JoeyStrandnes/C-tron_SensorConverter-Cerlic/Electrical/SensorConverter/PCB_Outline.dxf

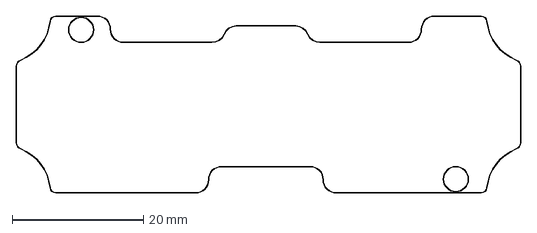
[picture p1: CAD file, 2025-03-11]
Electrical/SensorConverter/PCB_Outline.dxf
77.0 x 27.0 mm
