JoeyStrandnes/C-tron_SensorConverter-Cerlic/Electrical/SensorConverter/SensorConverter.kicad_pcb

## KiCad design Electrical/SensorConverter/SensorConverter.kicad_pcb (2025-04-03)

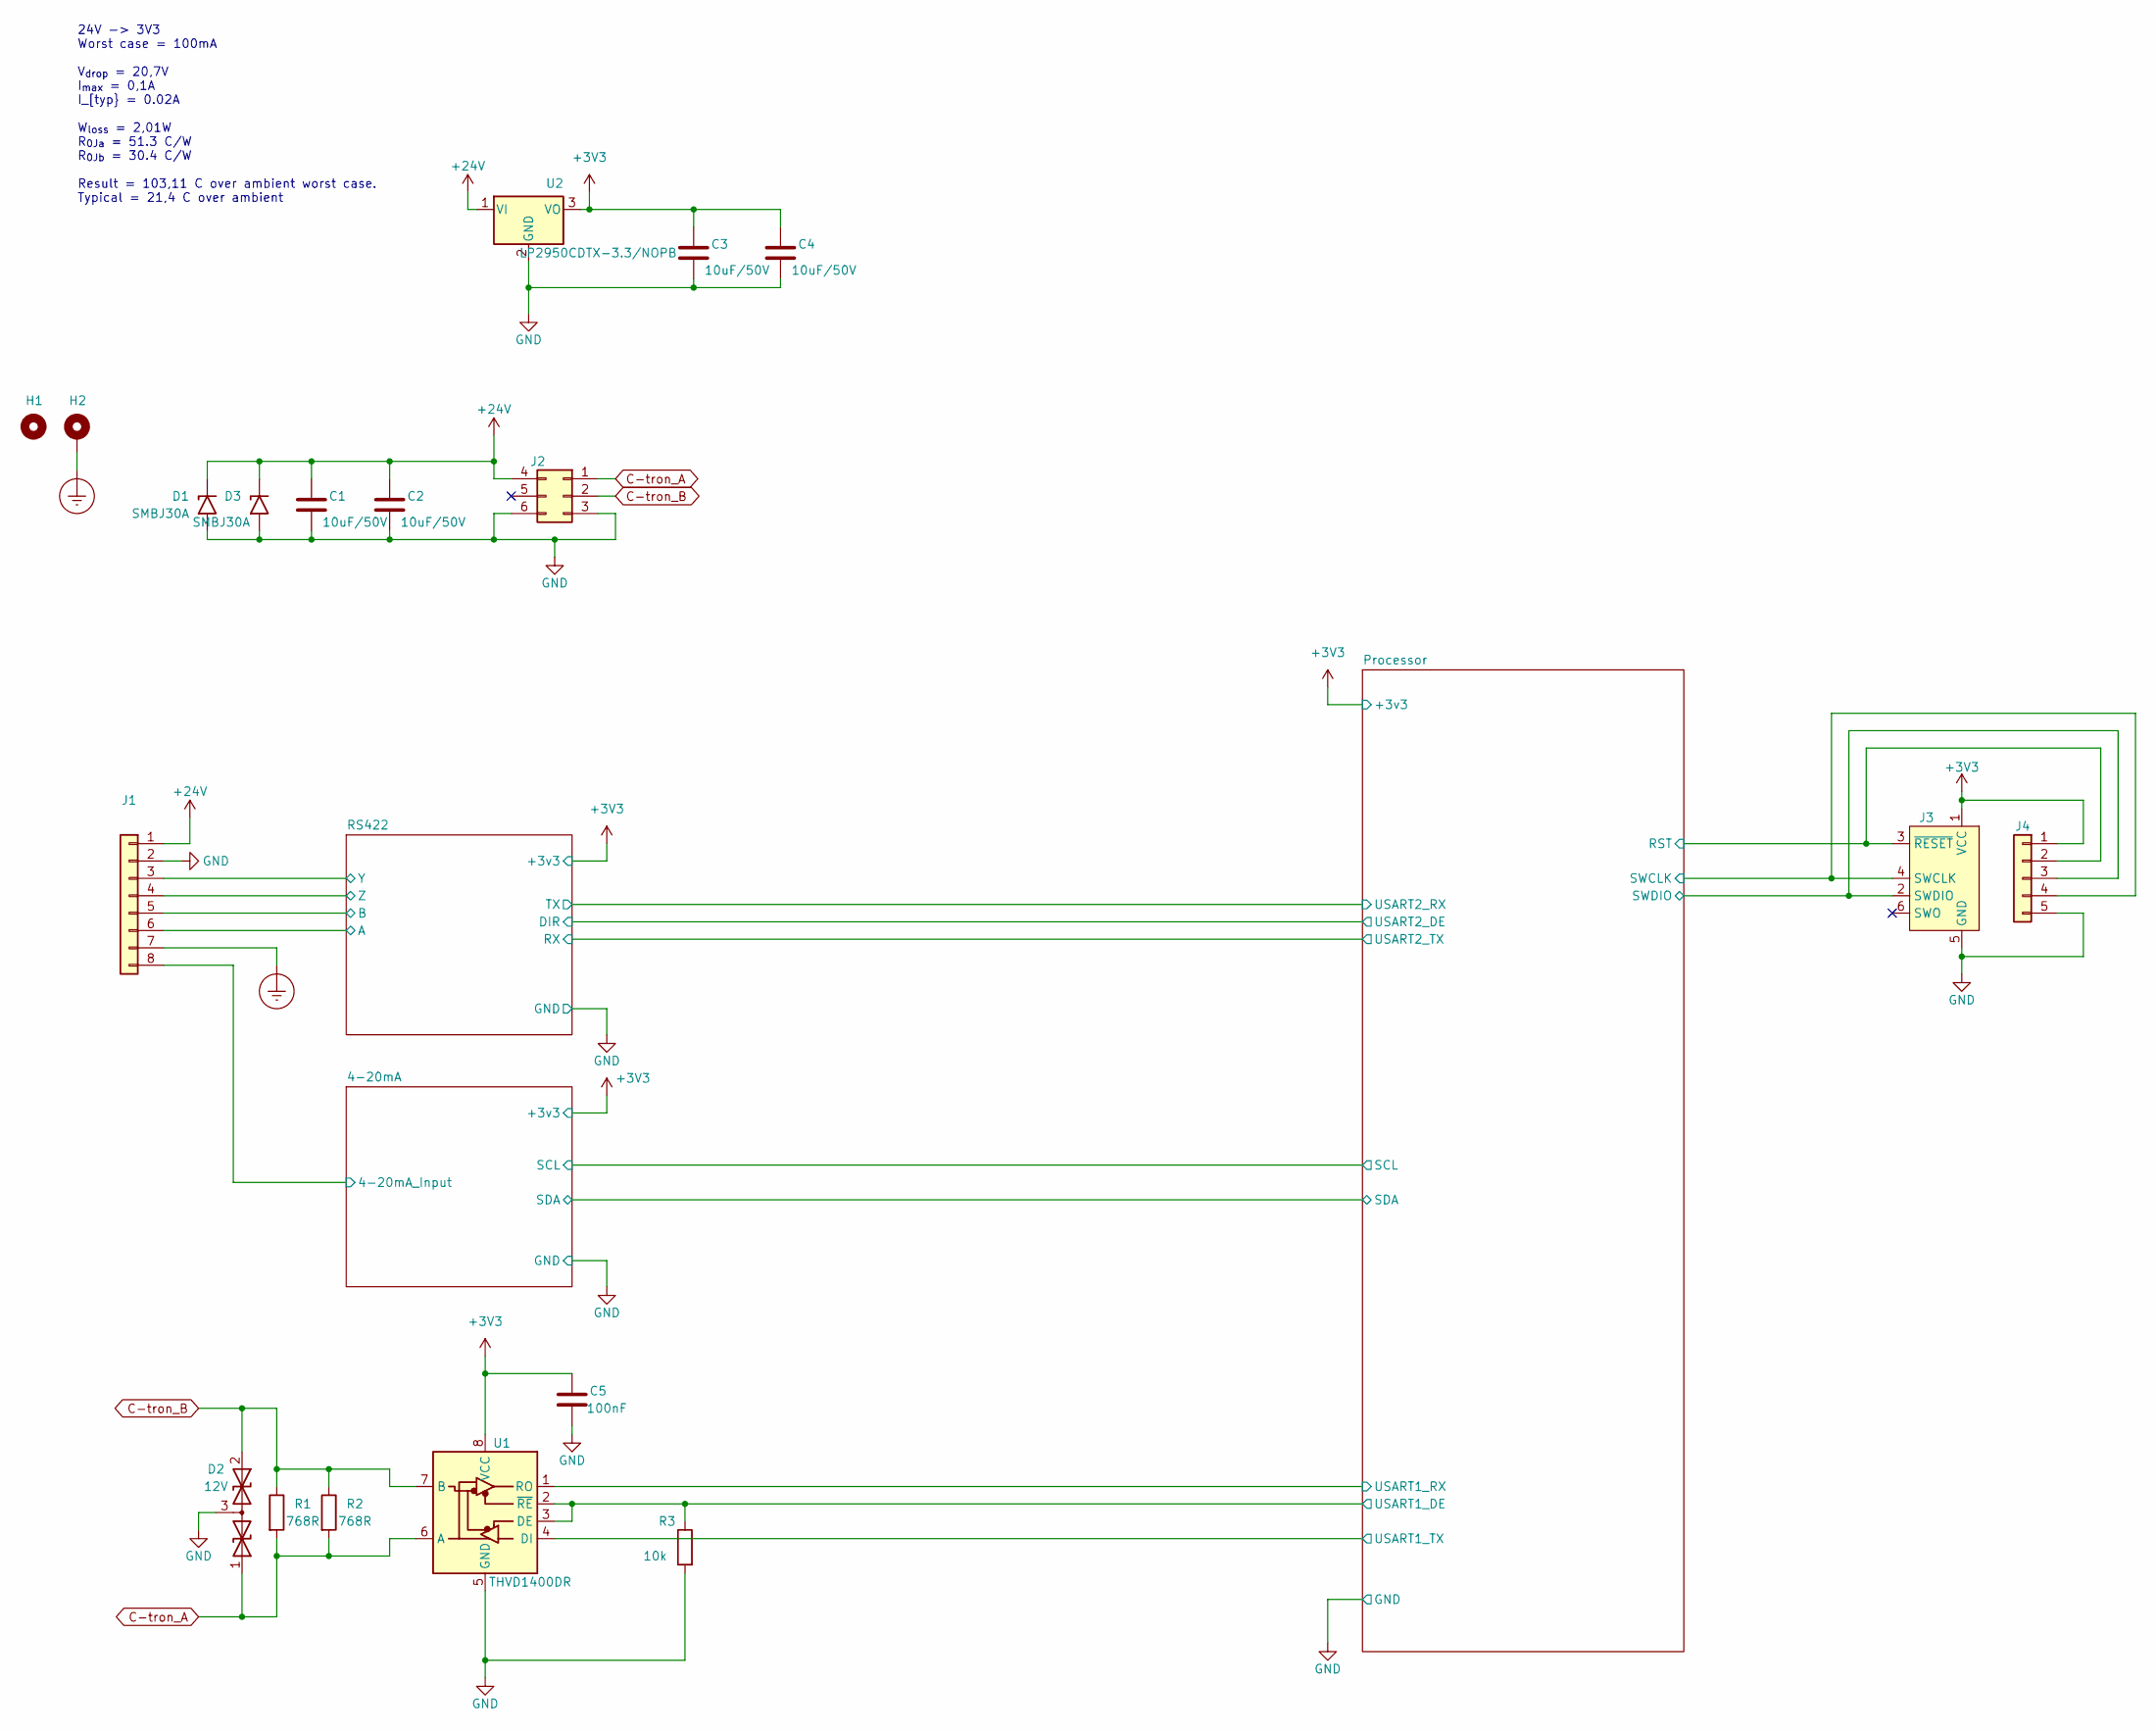
[picture p2: schematic SensorConverter.kicad_sch, Sensor Conversion board]

Parts:
C1, C2, C3, C4: 10uF/50V; C_1206_3216Metric
C5: 100nF; C_0402_1005Metric; Voltage 25V
D1, D3: SMBJ30A; D_SMB
D2: 12V; SOT-323_SC-70; MPN DF3D18FU,LF
H1: MountingHole; MountingHole_3.2mm_M3
H2: MountingHole_Pad; MountingHole_3.2mm_M3_DIN965_Pad
J1: 1990067
J2: 0430450600
J3: Conn_ARM_SWD_TagConnect_TC2030-NL; Tag-Connect_TC2030-IDC-NL_2x03_P1.27mm_Vertical
J4: Conn_01x05; PinHeader_1x05_P1.27mm_Vertical
R1, R2: 768R; R_0603_1608Metric
R3: 10k; R_0402_1005Metric
U1: THVD1400DR; SOIC-8_3.9x4.9mm_P1.27mm
U2: LP2950CDTX-3.3/NOPB; TO-252-2

Connections:
+3V3: C3.2, C4.2, C5.2, J3.1 (VCC), J4.1, U1.8 (VCC), U2.3 (VO); also elsewhere on the board
+24V: C1.2, C2.2, D1.1 (A1), D3.1 (A1), J1.1, J2.4, U2.1 (VI)
/4-20mA/4-20mA_Input: J1.8; also elsewhere on the board
/Processor/RST: J3.3 (~RESET), J4.2; also elsewhere on the board
/Processor/SWCLK: J3.4 (SWCLK), J4.4; also elsewhere on the board
/Processor/SWDIO: J3.2 (SWDIO), J4.3; also elsewhere on the board
/Processor/USART1_DE: R3.1, U1.2 (~RE), U1.3 (DE); also elsewhere on the board
/Processor/USART1_RX: U1.1 (RO); also elsewhere on the board
/Processor/USART1_TX: U1.4 (DI); also elsewhere on the board
/RS422/A: J1.6; also elsewhere on the board
/RS422/B: J1.5; also elsewhere on the board
/RS422/Y: J1.3; also elsewhere on the board
/RS422/Z: J1.4; also elsewhere on the board
C-tron_A: D2.1 (A1), J2.1, R1.2, R2.2, U1.6 (A)
C-tron_B: D2.2 (A2), J2.2, R1.1, R2.1, U1.7 (B)
Earth_Protective: H2.1, J1.7
GND: C1.1, C2.1, C3.1, C4.1, C5.1, D1.2 (A2), D2.3 (common), D3.2 (A2), J1.2, J2.3, J2.6, J3.5 (GND), J4.5, R3.2, U1.5 (GND), U2.2 (GND); also elsewhere on the board

Notes on the sheet:
24V -> 3V3 Worst case = 100mA V_{drop} = 20,7V I_{max} = 0,1A I_[typ} = 0.02A W_{loss} = 2,01W R_{0Ja} = 51.3 C/W R_{0Jb} = 30.4 C/W Result = 103,11 C over ambient worst case. Typical = 21,4 C over ambient

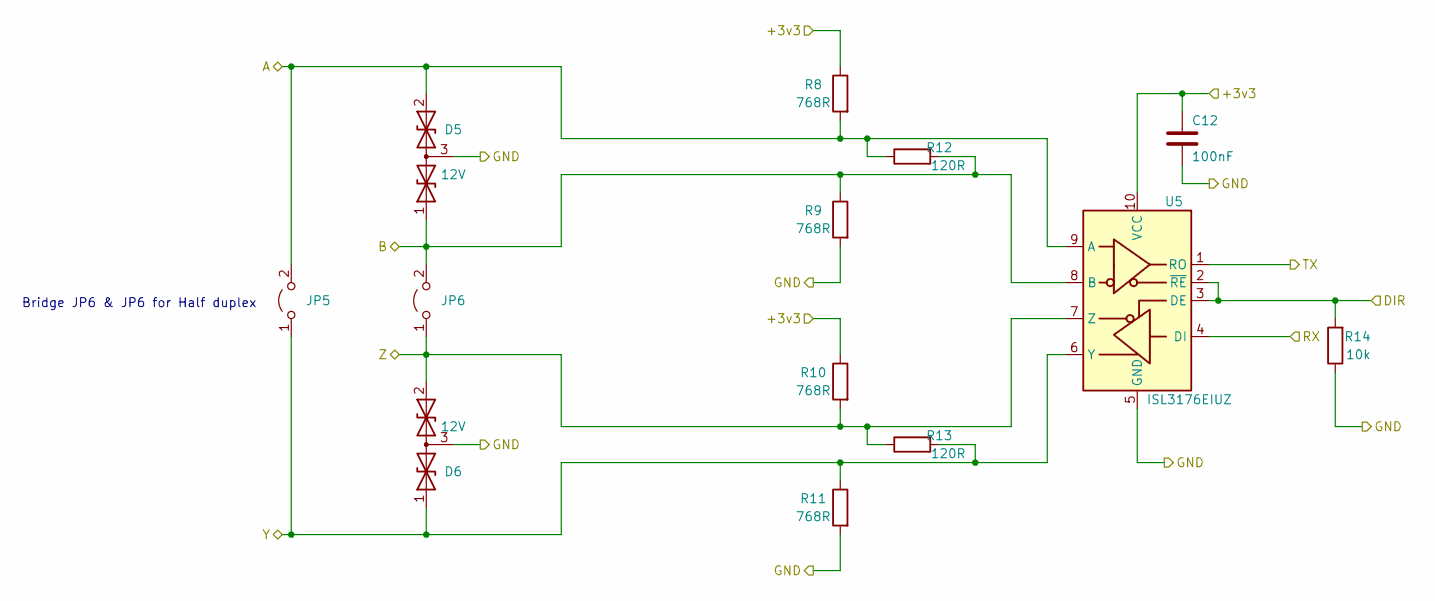
[picture p3: schematic RS422_FullDuplex.kicad_sch]

Parts:
C12: 100nF; C_0402_1005Metric; Voltage 50V
D5, D6: 12V; SOT-323_SC-70; MPN DF3D18FU,LF
JP5, JP6: Jumper_2_Open; SolderJumper-2_P1.3mm_Open_RoundedPad1.0x1.5mm
R8, R9, R10, R11: 768R; R_0603_1608Metric
R12, R13: 120R; R_0603_1608Metric
R14: 10k; R_0402_1005Metric
U5: ISL3176EIUZ; TSSOP-10_3x3mm_P0.5mm

Connections:
+3V3: C12.1, R8.1, R10.1, U5.10 (VCC); also elsewhere on the board
/Processor/USART2_DE: R14.2, U5.2 (~RE), U5.3 (DE); also elsewhere on the board
/Processor/USART2_RX: U5.1 (RO); also elsewhere on the board
/Processor/USART2_TX: U5.4 (DI); also elsewhere on the board
/RS422/A: D5.2 (A2), JP5.2 (B), R8.2, R12.1, U5.9 (A); also elsewhere on the board
/RS422/B: D5.1 (A1), JP6.2 (B), R9.1, R12.2, U5.8 (B); also elsewhere on the board
/RS422/Y: D6.1 (A1), JP5.1 (A), R11.1, R13.2, U5.6 (Y); also elsewhere on the board
/RS422/Z: D6.2 (A2), JP6.1 (A), R10.2, R13.1, U5.7 (Z); also elsewhere on the board
GND: C12.2, D5.3 (common), D6.3 (common), R9.2, R11.2, R14.1, U5.5 (GND); also elsewhere on the board

Notes on the sheet:
Bridge JP6 & JP6 for Half duplex

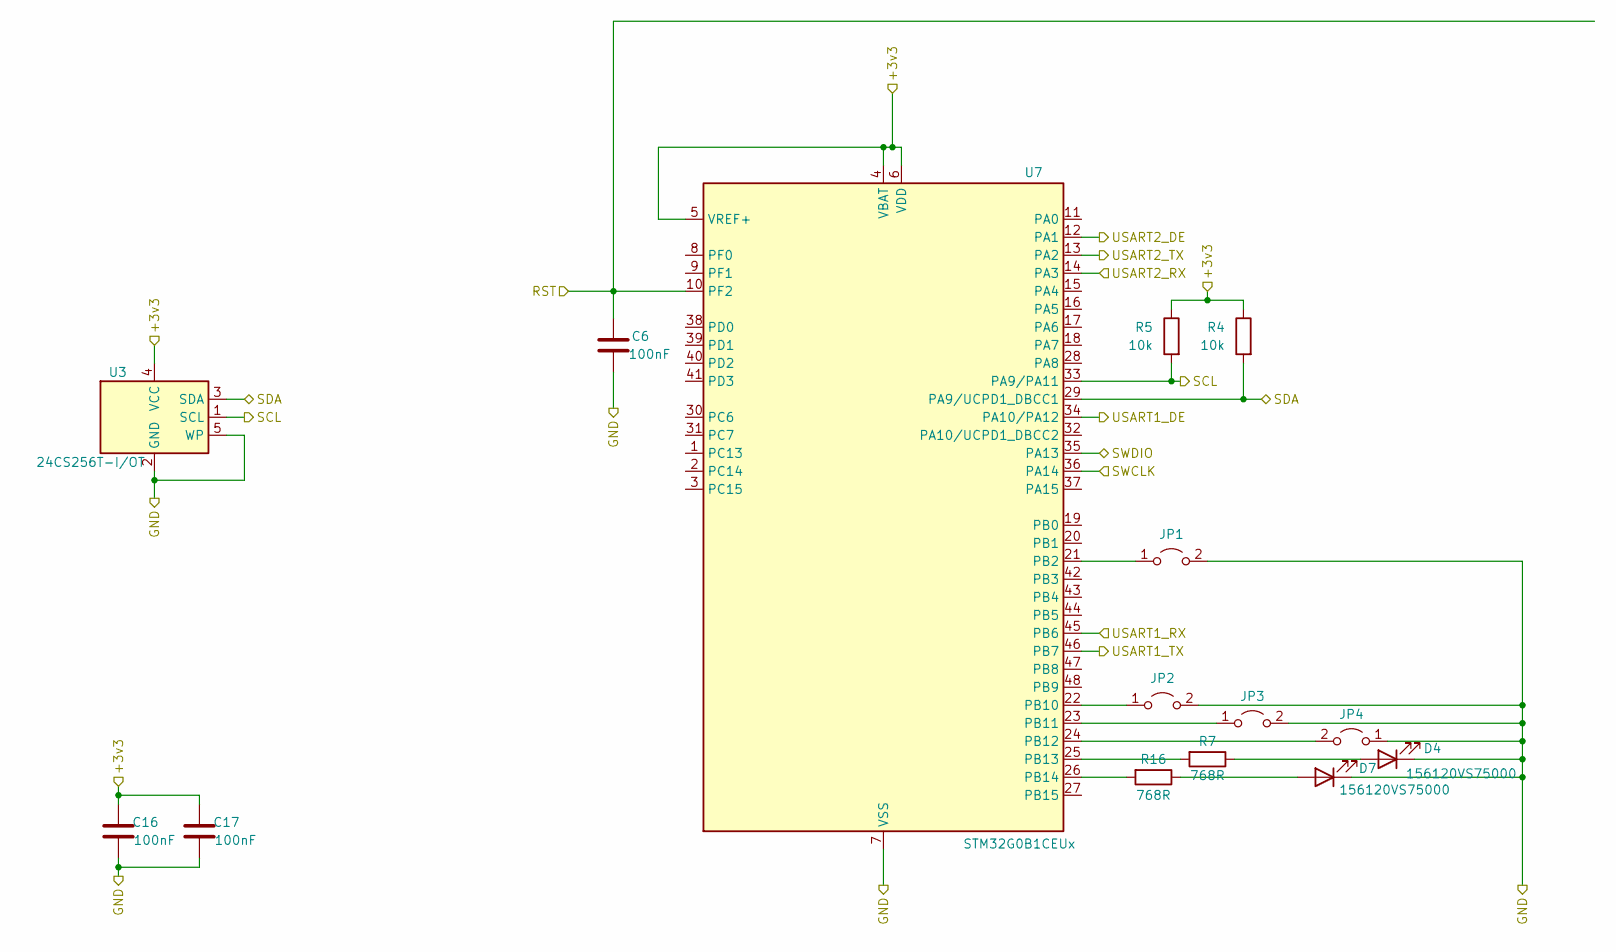
[picture p4: schematic STM32G0.kicad_sch]

Parts:
C6, C16, C17: 100nF; C_0402_1005Metric; Voltage 25V
D4, D7: 156120VS75000; WL-SMRW
JP1, JP2, JP3, JP4: Jumper_2_Open; SolderJumper-2_P1.3mm_Open_RoundedPad1.0x1.5mm
R4, R5: 10k; R_0402_1005Metric
R7, R16: 768R; R_0603_1608Metric
U3: 24CS256T-I/OT; SOT-23-5
U7: STM32G0B1CEUx; QFN-48-1EP_7x7mm_P0.5mm_EP5.6x5.6mm

Connections:
+3V3: C16.2, C17.2, R4.1, R5.1, U3.4 (VCC), U7.4 (VBAT), U7.5 (VREF+), U7.6 (VDD); also elsewhere on the board
/4-20mA/SCL: R5.2, U3.1 (SCL), U7.33 (PA9/PA11); also elsewhere on the board
/4-20mA/SDA: R4.2, U3.3 (SDA), U7.29 (PA9/UCPD1_DBCC1); also elsewhere on the board
/Processor/RST: C6.2, U7.10 (PF2); also elsewhere on the board
/Processor/SWCLK: U7.36 (PA14); also elsewhere on the board
/Processor/SWDIO: U7.35 (PA13); also elsewhere on the board
/Processor/USART1_DE: U7.34 (PA10/PA12); also elsewhere on the board
/Processor/USART1_RX: U7.45 (PB6); also elsewhere on the board
/Processor/USART1_TX: U7.46 (PB7); also elsewhere on the board
/Processor/USART2_DE: U7.12 (PA1); also elsewhere on the board
/Processor/USART2_RX: U7.14 (PA3); also elsewhere on the board
/Processor/USART2_TX: U7.13 (PA2); also elsewhere on the board
GND: C6.1, C16.1, C17.1, D4.1 (K), D7.1 (K), JP1.2 (B), JP2.2 (B), JP3.2 (B), JP4.1 (A), U3.2 (GND), U3.5 (WP), U7.7 (VSS), U7.49 (VSS); also elsewhere on the board
unnamed: D4.2 (A), R7.1
unnamed: D7.2 (A), R16.1
unnamed: JP1.1 (A), U7.21 (PB2)
unnamed: JP2.1 (A), U7.22 (PB10)
unnamed: JP3.1 (A), U7.23 (PB11)
unnamed: JP4.2 (B), U7.24 (PB12)
unnamed: R7.2, U7.25 (PB13)
unnamed: R16.2, U7.26 (PB14)

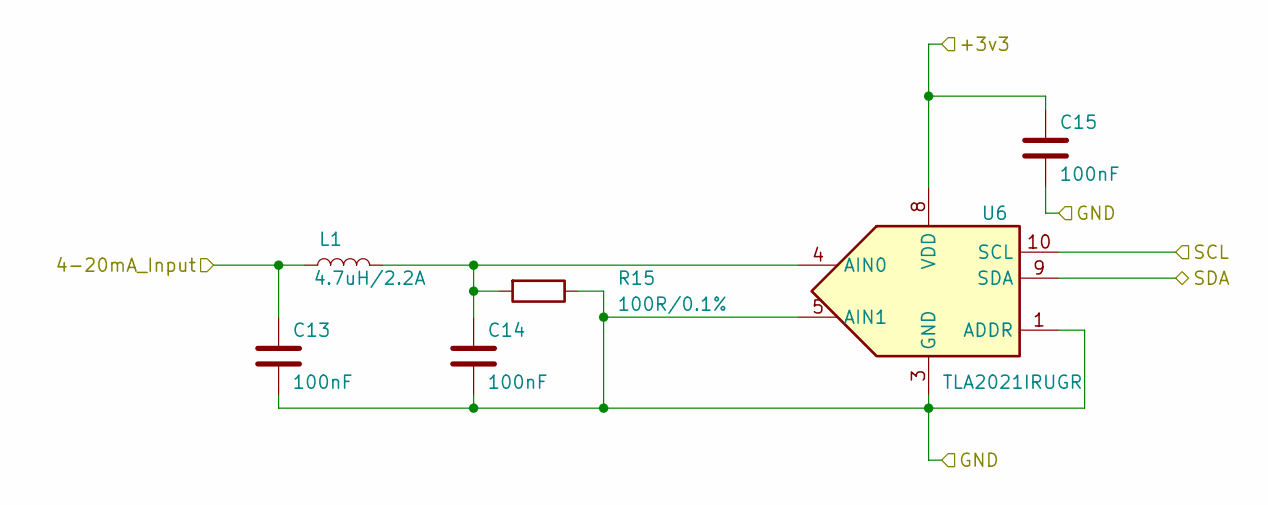
[picture p5: schematic 4-20mA.kicad_sch]

Parts:
C13, C14, C15: 100nF; C_0402_1005Metric; Voltage 50V
L1: 4.7uH/2.2A; L_1210_3225Metric; MPN SRP3212-4R7M
R15: 100R/0.1%; R_0603_1608Metric
U6: TLA2021IRUGR; Texas_R-PUQFN-N10

Connections:
+3V3: C15.1, U6.8 (VDD); also elsewhere on the board
/4-20mA/4-20mA_Input: C13.1, L1.1; also elsewhere on the board
/4-20mA/SCL: U6.10 (SCL); also elsewhere on the board
/4-20mA/SDA: U6.9 (SDA); also elsewhere on the board
GND: C13.2, C14.2, C15.2, R15.1, U6.1 (ADDR), U6.3 (GND), U6.5 (AIN1); also elsewhere on the board
unnamed: C14.1, L1.2, R15.2, U6.4 (AIN0)

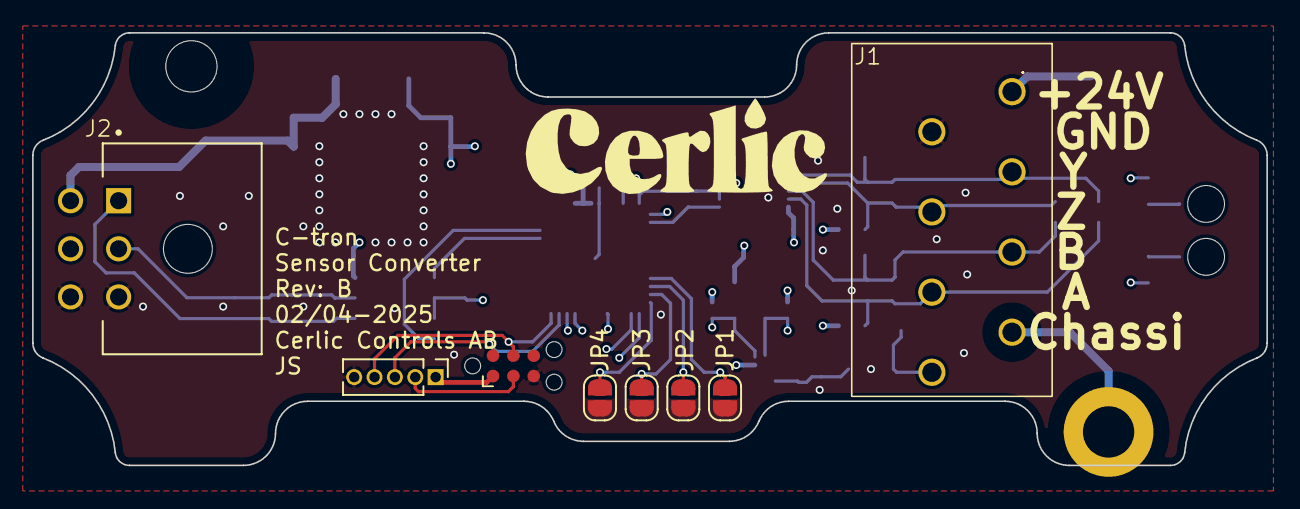
[picture p6: board SensorConverter.kicad_pcb from above]

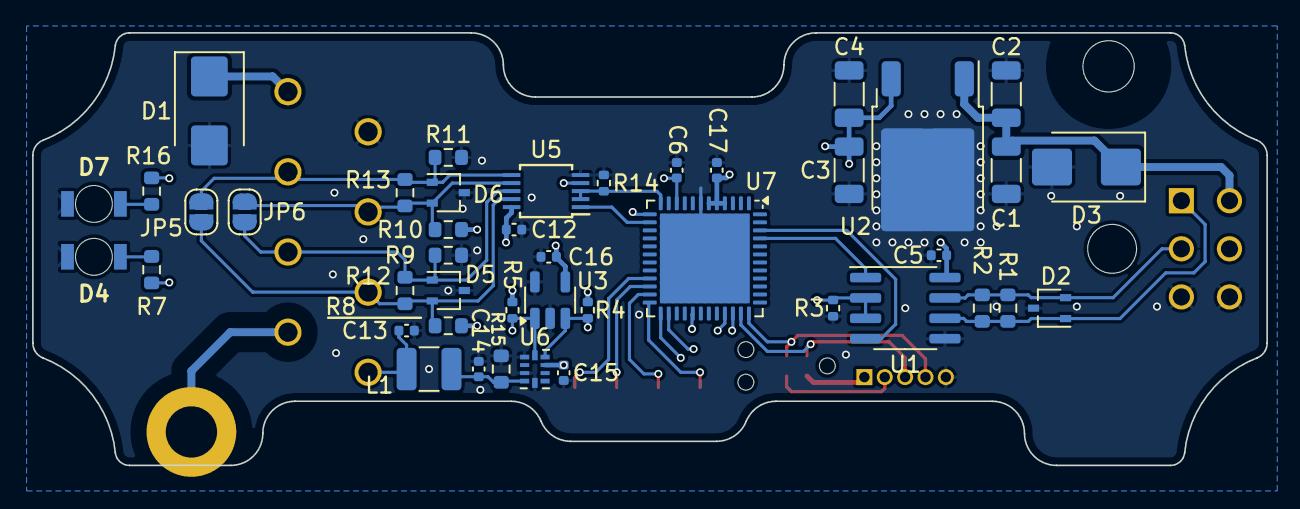
[picture p7: board SensorConverter.kicad_pcb from below]

Board: 4 copper layers, 77.0 x 27.0 mm, 53 parts (43 on the bottom side), 31 nets.
