JoeyStrandnes/C-tron_SensorConverter-Cerlic/Software/Core/Src/main.cpp

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
/* Includes ------------------------------------------------------------------*/
#include "main.h"
#include "crc.h"
#include "tim.h"
#include "usart.h"
#include "gpio.h"

/* USER CODE BEGIN Includes */
#include <SensorConverter.hpp>
/* USER CODE END Includes */


/* USER CODE BEGIN PV */
volatile uint8_t SlaveRxBuffer[32];
volatile uint8_t SlaveTxBuffer[256];

volatile uint8_t MasterRxBuffer[256];
volatile uint8_t MasterTxBuffer[32];

class ModBusRTU_SlaveClass ModBusSlave;
class ModBusRTU_MasterClass ModBusMaster;

extern DMA_HandleTypeDef hdma_usart1_rx;
/* USER CODE END PV */

void SystemClock_Config(void);
/* USER CODE BEGIN PFP */
extern "C"{
	void UART1_IRQ();

}
/* USER CODE END PFP */

/**
  * @brief  The application entry point.
  * @retval int
  */
int main(void)
{

  /* MCU Configuration--------------------------------------------------------*/

  /* Reset of all peripherals, Initializes the Flash interface and the Systick. */
  HAL_Init();

  /* Configure the system clock */
  SystemClock_Config();

  /* Initialize all configured peripherals */
  MX_GPIO_Init();
  MX_USART1_UART_Init();
  MX_USART2_UART_Init();
  MX_TIM3_Init();
  MX_TIM4_Init();
  MX_CRC_Init();
  MX_TIM2_Init();
  /* USER CODE BEGIN 2 */
  class SensorConverterSettings Settings(
		  LED_GPIO_Port,
		  LED_Pin,

		  JP1_GPIO_Port,
		  JP1_Pin,

		  JP2_GPIO_Port,
		  JP2_Pin,

		  JP3_GPIO_Port,
		  JP3_Pin,

		  JP4_GPIO_Port,
		  JP4_Pin

  );

//ModBus Slave
  ModBusSlave.SettingsPtr = &Settings;
  ModBusSlave.Address = Settings.SlaveAddress;

  ModBusSlave.OutputBuffer = (uint8_t *)SlaveTxBuffer;
  ModBusSlave.InputBuffer = (uint8_t *)SlaveRxBuffer;

  ModBusSlave.OutputBufferSize = sizeof(SlaveTxBuffer)/sizeof(SlaveTxBuffer[0]);
  ModBusSlave.InputBufferSize = sizeof(SlaveRxBuffer)/sizeof(SlaveRxBuffer[0]);

//ModBus Master
  ModBusMaster.SettingsPtr = &Settings;
  ModBusMaster.Address = Settings.MasterAddress;

  ModBusMaster.OutputBuffer = (uint8_t *)MasterTxBuffer;
  ModBusMaster.InputBuffer = (uint8_t *)MasterRxBuffer;

  ModBusMaster.OutputBufferSize = sizeof(MasterTxBuffer)/sizeof(MasterTxBuffer[0]);
  ModBusMaster.InputBufferSize = sizeof(MasterRxBuffer)/sizeof(MasterRxBuffer[0]);

  LinkSensorConfig(&ModBusMaster, &ModBusSlave, ModBusSlave.SettingsPtr->SensorType);

  ModBusMaster.ReadAllSensorData();

  HAL_GPIO_WritePin(USART2_DIR_GPIO_Port, USART2_DIR_Pin, GPIO_PIN_SET);
  HAL_UART_Transmit_IT(&huart2, (uint8_t *)ModBusMaster.OutputBuffer, ModBusMaster.ResponseSize);

  //Give it some time so startup in peace.
  //HAL_Delay(500);

  //Enable C-tron communication
  HAL_GPIO_WritePin(USART1_DIR_GPIO_Port, USART1_DIR_Pin, GPIO_PIN_RESET);
  LL_USART_EnableIT_RXNE(USART1);


  /* USER CODE END 2 */

  /* Infinite loop */
  /* USER CODE BEGIN WHILE */
  while (1)
  {
    /* USER CODE END WHILE */


    /* USER CODE BEGIN 3 */

  }
  /* USER CODE END 3 */
}

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
/* USER CODE BEGIN 4 */

void UART1_IRQ(){
//This gets called for every byte transmitted or received on the UART.

	if(LL_USART_IsActiveFlag_RXNE(USART1)){

		if(ModBusSlave.RequestSize >= ModBusSlave.InputBufferSize){ //ERROR
			ModBusSlave.RequestSize = 0;
		}

		HAL_TIM_Base_Start_IT(&htim2);

		(void)USART1->SR;
		ModBusSlave.InputBuffer[ModBusSlave.RequestSize++] = USART1->DR; //Also clears flag

		return;
	}

	if(LL_USART_IsActiveFlag_TXE(USART1)){ //We are sending data

		HAL_TIM_Base_Stop_IT(&htim2);

		if(ModBusSlave.ResponseSize != 0){

			if(ModBusSlave.TransmittedBytes <= ModBusSlave.ResponseSize){ //Last byte isnt really transmitted since the direction is set to RX.
				USART1->DR = ModBusSlave.OutputBuffer[ModBusSlave.TransmittedBytes++];

				return;
			}

			std::memset(ModBusSlave.OutputBuffer, 0, ModBusSlave.OutputBufferSize);

		}

		//Clear the status flags
		(void)USART1->SR;
		(void)USART1->DR;

		//Disable the TX line and enable the RX.
		USART1->CR1 = ((USART1->CR1 & ~(USART_CR1_TXEIE | USART_SR_TC)) | USART_CR1_RXNEIE);

		ModBusSlave.RequestSize = 0;
		ModBusSlave.TransmittedBytes = 0;

		HAL_GPIO_WritePin(USART1_DIR_GPIO_Port, USART1_DIR_Pin, GPIO_PIN_RESET);
		HAL_GPIO_WritePin(LED_GPIO_Port, LED_Pin, GPIO_PIN_RESET);

		return;
	}

	//Clear flag if we have an error
	(void)USART1->SR;
	(void)USART1->DR;

	return;
}


void HAL_TIM_PeriodElapsedCallback(TIM_HandleTypeDef *htim){


	if(htim->Instance == TIM2){
		//We get here when a transmission on UART 1 is IDLE. Basically a crude IDLE detection.

		HAL_TIM_Base_Stop_IT(htim);

		LoadModBusRegisters(&ModBusMaster, &ModBusSlave, ModBusSlave.SettingsPtr->SensorType);

		ModBusSlave.ParseMasterRequest();

		LL_USART_DisableIT_RXNE(USART1);
		LL_USART_ClearFlag_RXNE(USART1);

		ModBusSlave.RequestSize = 0;
		ModBusSlave.TransmittedBytes = 0;

		std::memset(ModBusSlave.InputBuffer, 0, ModBusSlave.InputBufferSize);

		HAL_TIM_Base_Start_IT(&htim4);

		return;
	}

	if(htim->Instance == TIM3){

		HAL_GPIO_WritePin(USART2_DIR_GPIO_Port, USART2_DIR_Pin, GPIO_PIN_SET);

		HAL_UART_Transmit_IT(&huart2, (uint8_t *)ModBusMaster.OutputBuffer, ModBusMaster.ResponseSize);
		HAL_TIM_Base_Stop_IT(htim);

		return;
	}

	//Delay for the response to C-tron
	if(htim->Instance == TIM4){

		HAL_TIM_Base_Stop_IT(htim);

		HAL_GPIO_WritePin(USART1_DIR_GPIO_Port, USART1_DIR_Pin, GPIO_PIN_SET);
		HAL_GPIO_WritePin(LED_GPIO_Port, LED_Pin, GPIO_PIN_SET);

		//LL_USART_ClearFlag_TC(USART1);
		LL_USART_EnableIT_TXE(USART1);

		return;
	}

}

void HAL_UARTEx_RxEventCallback(UART_HandleTypeDef *huart, uint16_t Size){

	if(huart->Instance == USART2){

		ModBusMaster.RequestSize = Size;
		ModBusMaster.ParseSlaveResponse();

		std::memset((uint8_t *)ModBusMaster.InputBuffer, 0, ModBusMaster.InputBufferSize);

		(void)huart->Instance->SR;
		(void)huart->Instance->DR;


	}

	return;
}

void HAL_UART_TxCpltCallback(UART_HandleTypeDef *huart){


	if(huart->Instance == USART2){

		HAL_GPIO_WritePin(LED_GPIO_Port, LED_Pin, GPIO_PIN_RESET);
		HAL_GPIO_WritePin(USART2_DIR_GPIO_Port, USART2_DIR_Pin, GPIO_PIN_RESET);

		HAL_UARTEx_ReceiveToIdle_IT(&huart2, (uint8_t *)ModBusMaster.InputBuffer, 20);

		HAL_TIM_Base_Start_IT(&htim3); //Overflows after 250 ms. Used to indicate "loss of sensors"

	}

	return;
}

void HAL_UART_ErrorCallback(UART_HandleTypeDef *huart){


	//UART for SCADA
	if(huart->Instance == USART2){

		(void)huart->Instance->SR;
		(void)huart->Instance->DR;

	}


	return;
}


/* USER CODE END 4 */
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
