JoeyStrandnes/C-tron_SensorConverter-Cerlic/Electrical/Electrical.ioc

Mcu.UserName=STM32G0B1CEUx
PA1.Signal=USART2_DE
PA10.Signal=USART1_RX
PA13.Signal=SYS_SWDIO
PA14-BOOT0.Signal=SYS_SWCLK
PA2.Signal=USART2_TX
PA3.Signal=USART2_RX
PA9.Signal=USART1_TX
PB10.GPIO_Label=JP2
PB10.Signal=GPIO_Input
PB11.GPIO_Label=JP3
PB11.Signal=GPIO_Input
PB12.GPIO_Label=JP4
PB12.Signal=GPIO_Input
PB13.Signal=GPIO_Output
PB14.GPIO_Label=LED_2
PB14.Signal=GPIO_Output
PB2.Signal=GPIO_Input
PB3.Signal=USART1_DE
PB6.Signal=I2C1_SCL
PB7.Signal=I2C1_SDA
