JoeyStrandnes/C-tron_SensorConverter-Cerlic/Software/Core/Inc/main.h

#define USART2_DIR_Pin GPIO_PIN_1
#define USART2_DIR_GPIO_Port GPIOA
#define JP4_Pin GPIO_PIN_7
#define JP4_GPIO_Port GPIOA
#define JP1_Pin GPIO_PIN_0
#define JP1_GPIO_Port GPIOB
#define JP2_Pin GPIO_PIN_1
#define JP2_GPIO_Port GPIOB
#define JP3_Pin GPIO_PIN_2
#define JP3_GPIO_Port GPIOB
#define USART1_DIR_Pin GPIO_PIN_8
#define USART1_DIR_GPIO_Port GPIOA
#define LED_Pin GPIO_PIN_12
#define LED_GPIO_Port GPIOA
