JoeyStrandnes/C-tron_SensorConverter-Cerlic/(commit log)

2025-03-11 Project init
    [4-20mA.kicad_sch, PCB_Outline.dxf, RS422_FullDuplex.kicad_sch, SensorConverter.kicad_pcb, SensorConverter.kicad_sch]
2025-03-11 Added DMA to the UART channels
2025-03-12 Working IT driven COM. DMA not so much
2025-03-18 Removed UART DMA
2025-03-19 Reworking UART implementation
2025-03-19 Lots of UART testing
2025-03-24 Still some issues with NVM
    [SensorConverter.cpp, SensorConverter.ioc]
2025-03-25 Fixed UART deadlock bug
    [main.cpp]
2025-03-25 Added factory reset command
    [ModBus.cpp, SensorConverter.cpp, SensorConverter.hpp]
2025-03-25 Issues with I2C not sending data....
    [ModBus.cpp, SensorConverter.cpp, SensorConverter.hpp, SensorConverter.ioc, main.cpp, main.h]
2025-03-25 Working on LFX flow calculations
2025-03-25 Working on a dynamic sensor system
2025-04-01 Working on the FLX calibration
2025-04-02 Fixed register size and cleaned code
    [FLX_Calculations.cpp, SensorConverter.hpp, SensorRegisterMaps.cpp, SensorRegisterMaps.hpp]
2025-04-02 Changing processor to STM32G0
    This is mostly because of memory constraints and that the F103 is having a lot of issue.
    [4-20mA.kicad_sch, RS422_FullDuplex.kicad_sch, STM32G0.kicad_sch, SensorConverter.kicad_pcb, SensorConverter.kicad_sch]
2025-04-02 Finalized PCB RevB
    [STM32G0.kicad_sch, SensorConverter.kicad_pcb, SensorConverter.kicad_sch]
2025-04-03 Fixed minor changes in PCB
    [STM32G0.kicad_sch, SensorConverter.kicad_pcb]
2025-04-04 Clear UART flags when an error occors
    [main.cpp]
2025-04-04 Removed I2C drivers since it is not working...
    [SensorConverter.cpp, SensorConverter.ioc, main.cpp, main.h]
2025-04-07 Working on zero/offset calibration
2025-04-07 Basic offset calibration
2025-04-07 Sensor input/raw data is now a pointer
2025-04-07 Write correct ModBus address to NVM
    [ModBus.cpp]
2025-04-07 Fixed incorrect formatting of TAG
    [SensorRegisterMaps.cpp]
2025-04-07 Fixed bug typecasting floats to ints
    [SensorConverter.cpp]
