JoeyStrandnes/C-tron_SensorConverter-Cerlic/(notices)

Notices in the files:
Software/Core/Src/main.cpp:
Copyright (c) 2025 STMicroelectronics.
All rights reserved.
This software is licensed under terms that can be found in the LICENSE file
